Jasdoge/Rinsense/pics/printed_parts.jpg

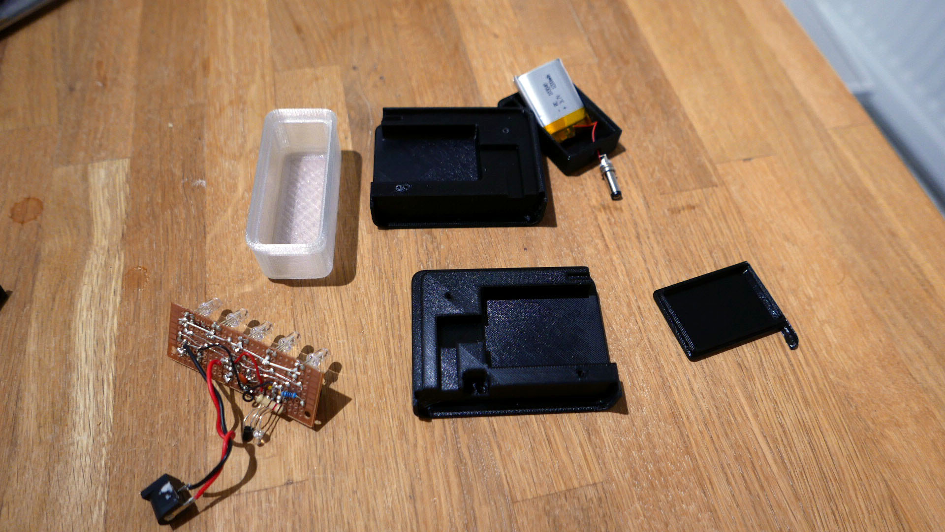
pics/printed_parts.jpg
