Jasdoge/Rinsense/pics/suggested_parts.jpg

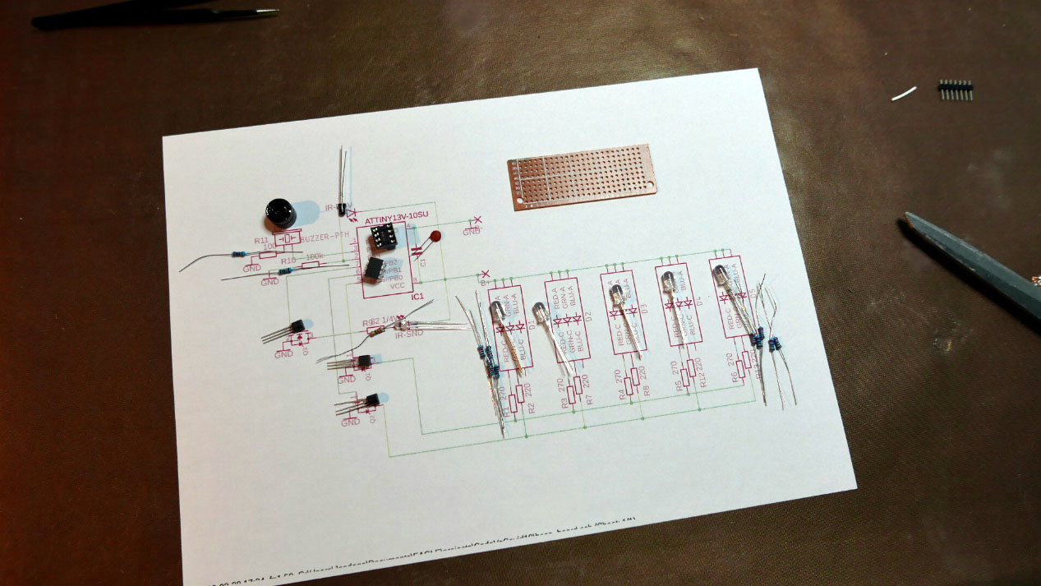
pics/suggested_parts.jpg
