Jasdoge/Rinsense/circuitry/circuit.png

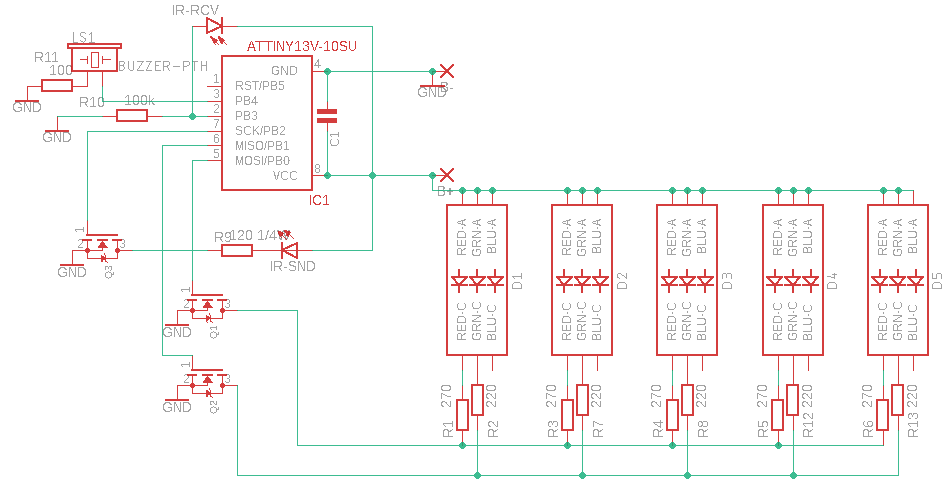
circuitry/circuit.png
