Jasdoge/Rinsense/pics/front_panel.jpg

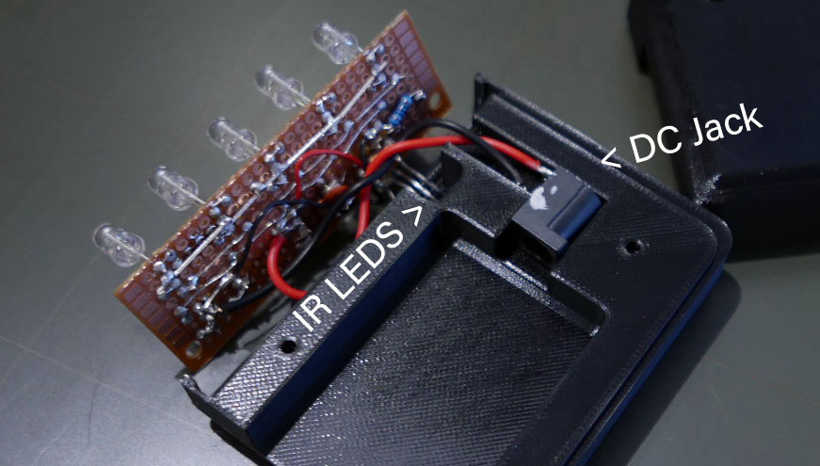
pics/front_panel.jpg
