Jasdoge/Rinsense/pics/top_layout.jpg

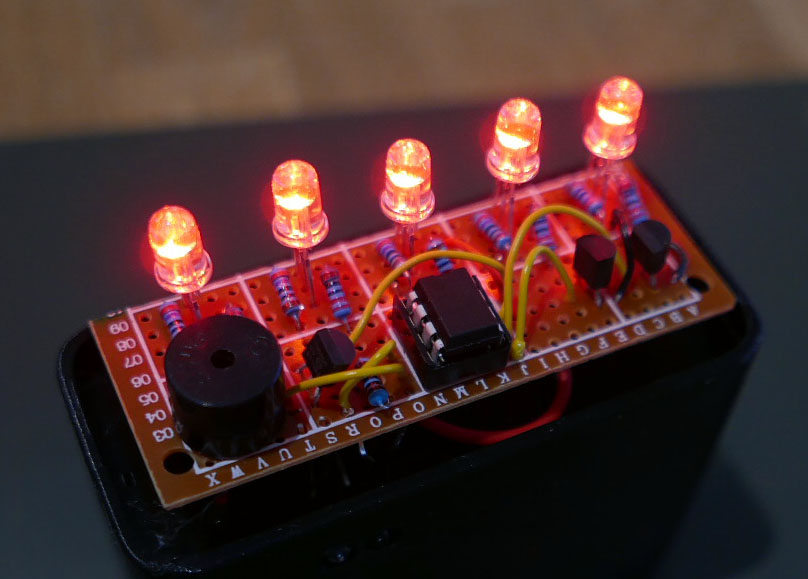
pics/top_layout.jpg
