Jasdoge/Rinsense/3d_prints/mmu_charger_front/charger_front_black.STL

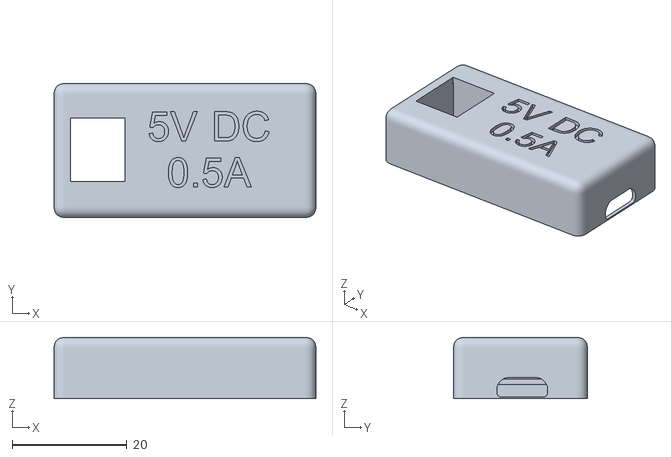
[picture p6: CAD file, 2020-03-30]
3d_prints/mmu_charger_front/charger_front_black.STL
45.6 x 23.3 x 10.7
