Jasdoge/Rinsense/3d_prints/mmu_enclosure_front/panel_front_red.STL

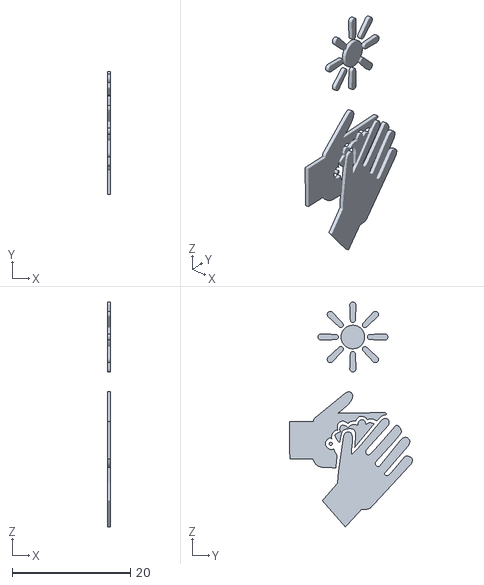
[picture p7: CAD file, 2020-03-30]
3d_prints/mmu_enclosure_front/panel_front_red.STL
0.569 x 20.8 x 38.0
