Jasdoge/Rinsense/3d_prints/non_mmu_black_parts/charger_back.STL

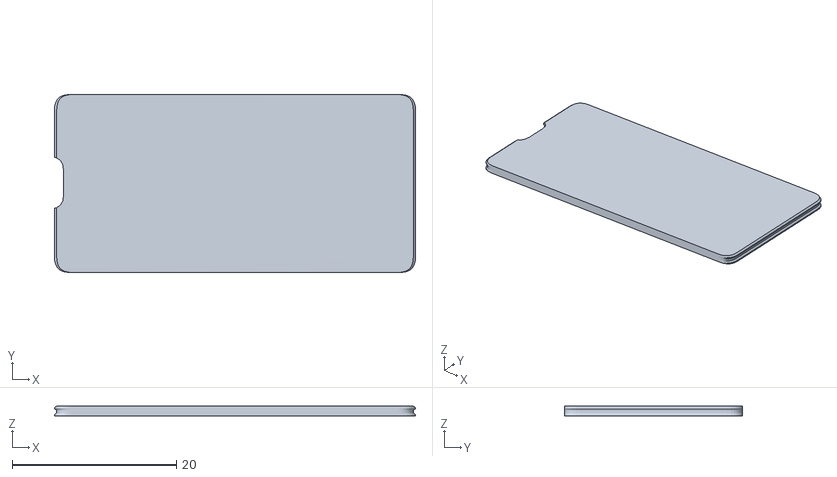
[picture p8: CAD file, 2020-03-30]
3d_prints/non_mmu_black_parts/charger_back.STL
43.9 x 21.7 x 1.23
