Jasdoge/Rinsense/3d_prints/non_mmu_transparent/panel_bottom.STL

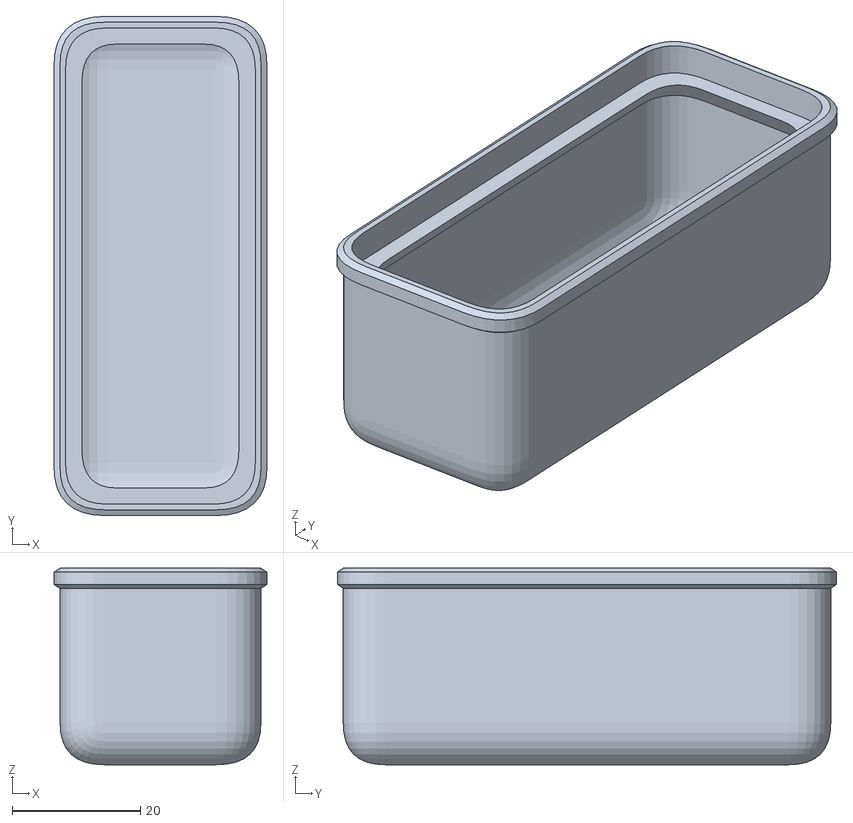
[picture p9: CAD file, 2020-03-30]
3d_prints/non_mmu_transparent/panel_bottom.STL
33.2 x 77.8 x 30.6
