Jasdoge/Rinsense/3d_prints/mmu_charger_front/charger_front_transparent.STL

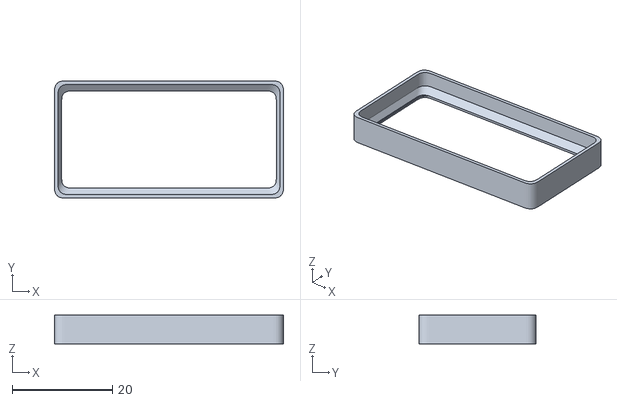
[picture p10: CAD file, 2020-03-30]
3d_prints/mmu_charger_front/charger_front_transparent.STL
45.6 x 23.3 x 5.72
