Jasdoge/Rinsense/3d_prints/mmu_enclosure_front/panel_front_green.STL

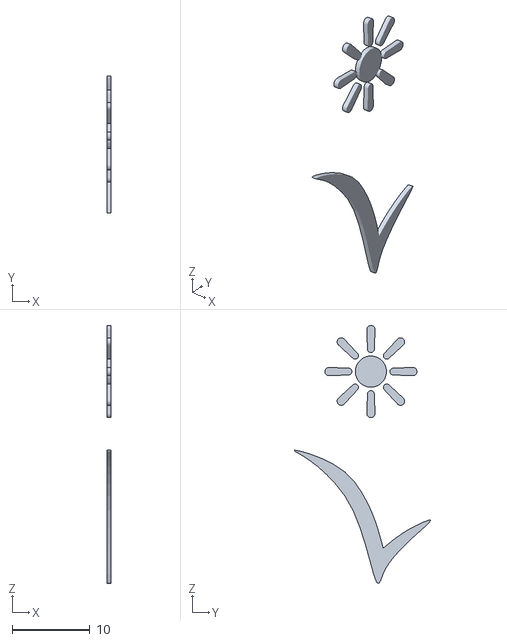
[picture p11: CAD file, 2020-03-30]
3d_prints/mmu_enclosure_front/panel_front_green.STL
0.569 x 17.6 x 33.1
