Jasdoge/Rinsense/3d_prints/non_mmu_black_parts/panel_back.STL

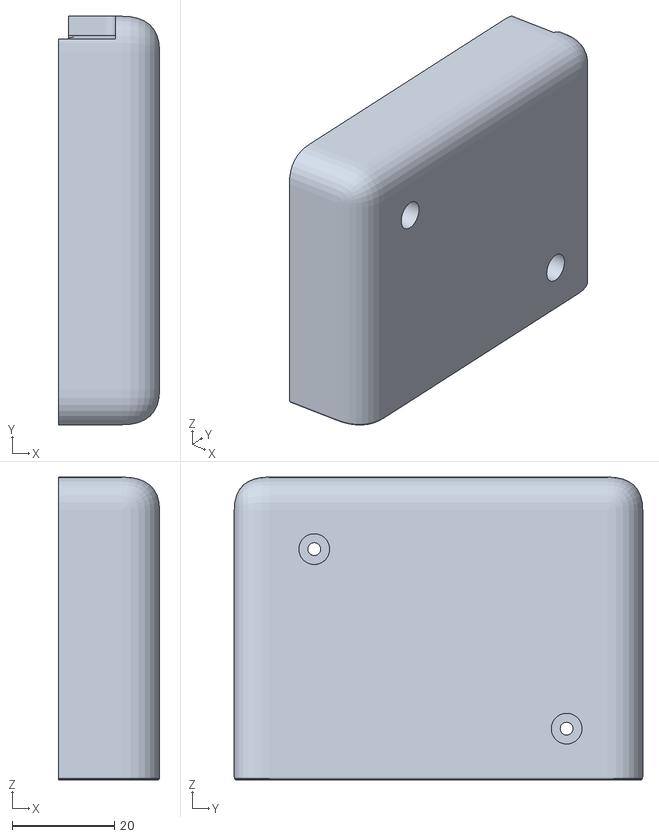
[picture p12: CAD file, 2020-03-30]
3d_prints/non_mmu_black_parts/panel_back.STL
19.8 x 79.8 x 59.2
