Jasdoge/Rinsense/3d_prints/mmu_enclosure_front/panel_front.STL

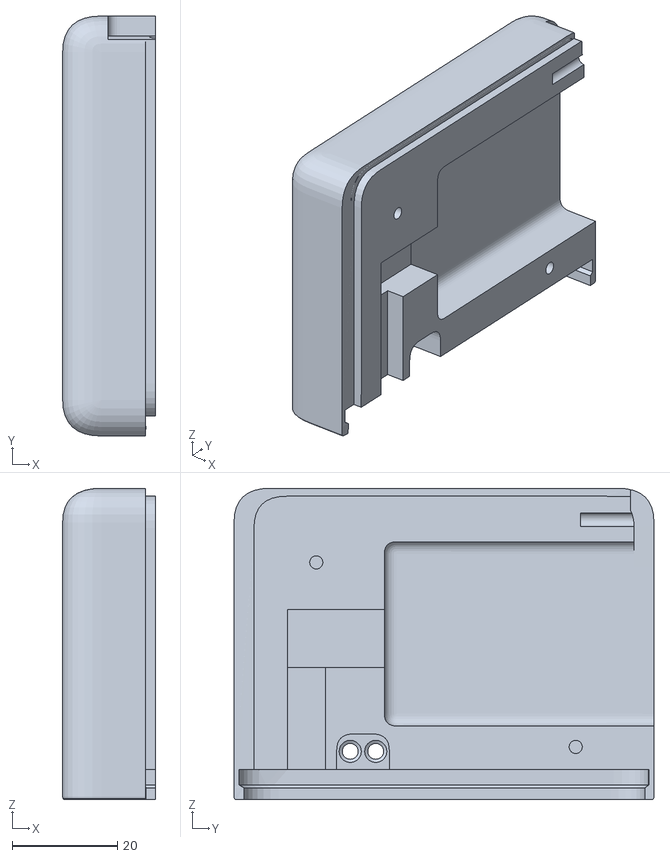
[picture p13: CAD file, 2020-03-30]
3d_prints/mmu_enclosure_front/panel_front.STL
17.6 x 79.8 x 59.2
