Jasdoge/Rinsense/3d_prints/non_mmu_black_parts/1200mahBoxTop.STL

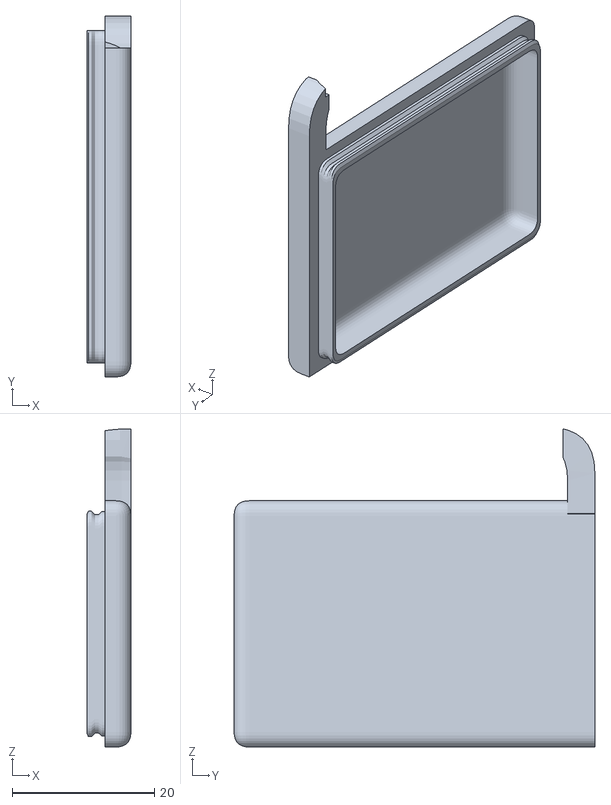
[picture p14: CAD file, 2020-03-30]
3d_prints/non_mmu_black_parts/1200mahBoxTop.STL
6.23 x 50.7 x 44.7
