Jasdoge/Rinsense/3d_prints/non_mmu_black_parts/1200mahBoxBottom.STL

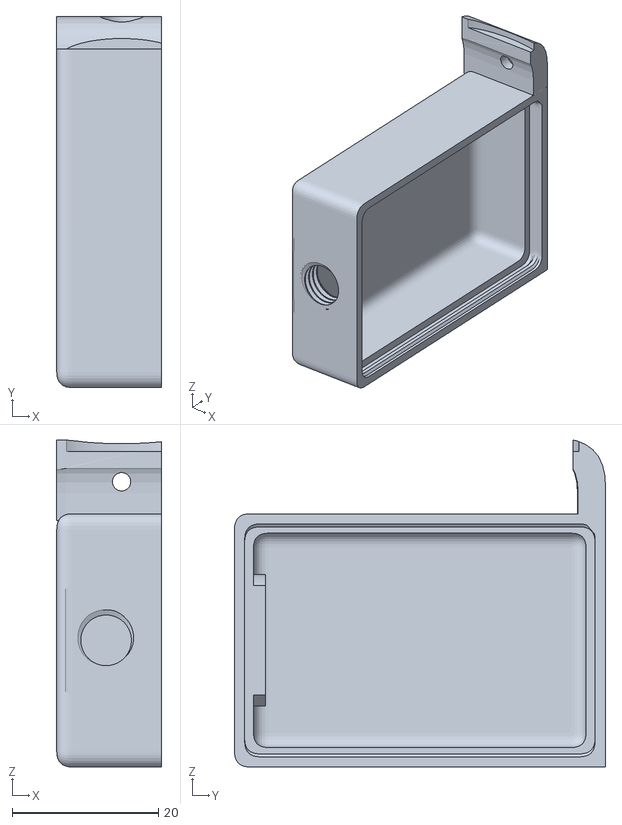
[picture p15: CAD file, 2020-03-30]
3d_prints/non_mmu_black_parts/1200mahBoxBottom.STL
14.4 x 50.7 x 44.7
