Jasdoge/Rinsense/circuitry/base_board.sch

## EAGLE design circuitry/base_board.sch (2020-03-30)

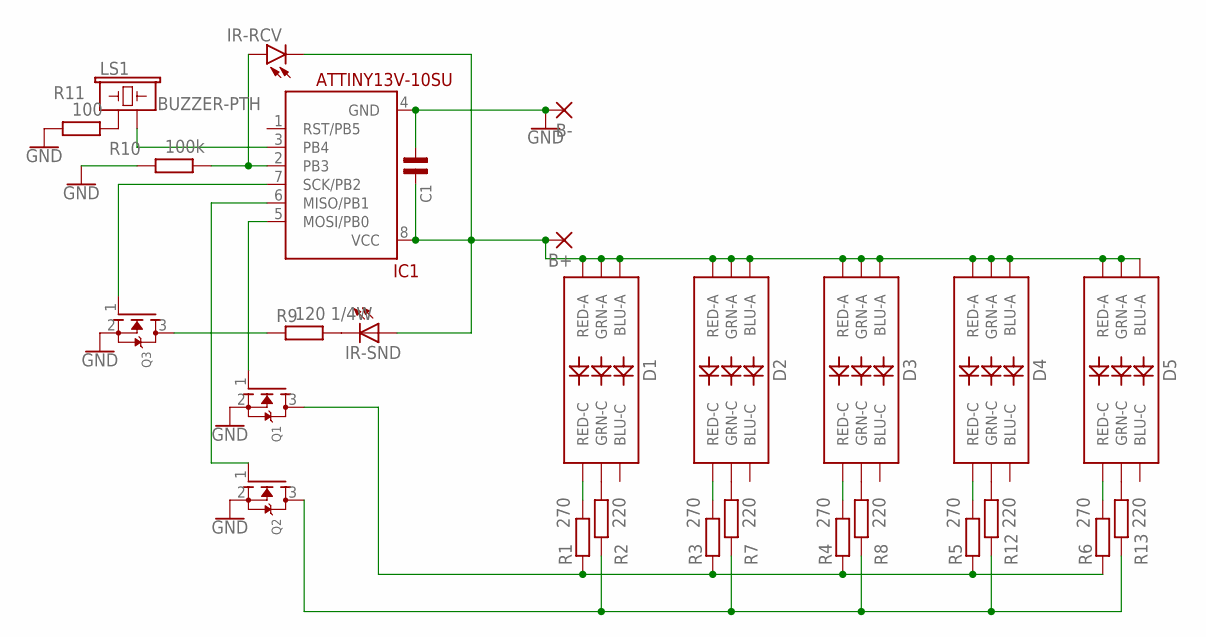
[picture p16: schematic base_board.sch]

Parts:
B+: 2,15/1,0
B-: 2,15/1,0
C1: C0805; 0805
D1, D2, D3, D4, D5: LED-RGBNO_IC; LED-TRICOLOR-5050
IC1: ATTINY13V-10SU; SOIC8
IR-RCV: LED_INPUT; LED3MM
IR-SND: LED3MM
LS1: BUZZER-PTH; BUZZER-12MM
Q1, Q2, Q3: MOSFET-NREFLOW; SOT23
R1, R3, R4, R5, R6: 270; R2012
R2, R7, R8, R12, R13: 220; R2012
R9: 120 1/4W; R2012
R10: 100k; R2012
R11: 100; R2012

Connections:
GND: B-.1, C1.1, IC1.4 (GND), Q1.2 (S), Q2.2 (S), Q3.2 (S), R10.1, R11.1
unnamed: D2.5 (RED-C), R3.2
unnamed: D1.5 (RED-C), R1.2
unnamed: B+.1, C1.2, D1.1 (GRN-A), D1.2 (RED-A), D1.3 (BLU-A), D2.1 (GRN-A), D2.2 (RED-A), D2.3 (BLU-A), D3.1 (GRN-A), D3.2 (RED-A), D3.3 (BLU-A), D4.1 (GRN-A), D4.2 (RED-A), D4.3 (BLU-A), D5.1 (GRN-A), D5.2 (RED-A), D5.3 (BLU-A), IC1.8 (VCC), IR-RCV.K (C), IR-SND.A
unnamed: D3.5 (RED-C), R4.2
unnamed: D4.5 (RED-C), R5.2
unnamed: D5.5 (RED-C), R6.2
unnamed: D1.6 (GRN-C), R2.2
unnamed: D2.6 (GRN-C), R7.2
unnamed: D3.6 (GRN-C), R8.2
unnamed: IC1.5 (MOSI/PB0), Q1.1 (G)
unnamed: IC1.6 (MISO/PB1), Q2.1 (G)
unnamed: D4.6 (GRN-C), R12.2
unnamed: Q2.3 (D), R2.1, R7.1, R8.1, R12.1, R13.1
unnamed: IC1.7 (SCK/PB2), Q3.1 (G)
unnamed: Q3.3 (D), R9.1
unnamed: IR-SND.K (C), R9.2
unnamed: IC1.2 (PB3), IR-RCV.A, R10.2
unnamed: LS1.+ (1), R11.2
unnamed: IC1.3 (PB4), LS1.- (2)
unnamed: Q1.3 (D), R1.1, R3.1, R4.1, R5.1, R6.1
unnamed: D5.6 (GRN-C), R13.2
