Jasdoge/Rinsense/(commit log)

2020-03-27 fix power issues
2020-03-30 add 3d prints
    [1200mahBoxBottom.STL, 1200mahBoxTop.STL, charger_back.STL, charger_front_black.STL, charger_front_transparent.STL, panel_back.STL, panel_bottom.STL, panel_front.STL]
2020-03-30 Add circuit
    [base_board.sch]
2020-03-30 start on readme
    [panel_bottom.STL]
2021-02-14 power fix
2026-01-16 Moved stuff into old Better looking animations Fuckit, I'm out of memory :(
    [1200mahBoxBottom.STL, 1200mahBoxTop.STL, base_board.sch, charger_back.STL, charger_front_black.STL, charger_front_transparent.STL, panel_back.STL, panel_bottom.STL]
